aindustriosa/Video-consola-ESP32/hardware/pcb/lista_materiais.csv

Reference | Value | Footprint | QUANTITY
BZ1 | CEM-1203 | Buzzer_Beeper:MagneticBuzzer_ProSignal_ABT-410-RC | 1
C1,C2 | 100nF | PCM_fab:C_1206 | 2
D1 | 1N4148W | PCM_fab:LED_1206 | 1
J2 | TFT ILI9341 | Connector_PinHeader_2.54mm:PinHeader_1x14_P2.54mm_Vertical | 1
J_BAT1 | LiPo_3V7 | Connector_JST:JST_PH_S2B-PH-SM4-TB_1x02-1MP_P2.00mm_Horizontal | 1
M1 | Module_XIAO-ESP32C3 | PCM_fab:SeeedStudio_XIAO_ESP32C3 | 1
Q1 | MMBT3904 | Package_TO_SOT_SMD:SOT-23 | 1
Q2 | Transistor_MOSFET_NCh_SOT23 | PCM_fab:SOT-23-3 | 1
R2,R3 | 4k7 | PCM_fab:R_1206 | 2
R4,R11,R16 | 10K | PCM_fab:R_1206 | 3
R5,R6,R7,R12,R13,R14,R18 | 0 Ohm | PCM_fab:R_1206 | 7
R8,R9 | 100 K | PCM_fab:R_1206 | 2
R10,R17 | 1K | PCM_fab:R_1206 | 2
SW1,SW2,SW3,SW4,SW5,SW6,SW_MENU1 | SW_Push | Button_Switch_THT:SW_PUSH_6mm | 7
U1 | PCF8574A | Package_SO:SOIC-16W_7.5x10.3mm_P1.27mm | 1
