aindustriosa/Video-consola-ESP32/hardware/carcasa/traseira.stl

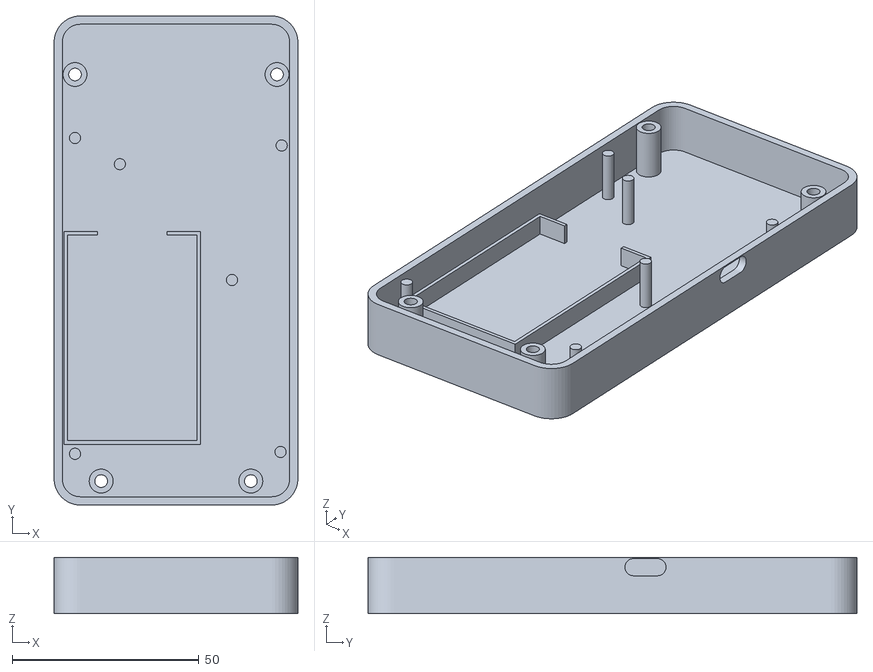
[picture p5: CAD file, 2026-10-26]
hardware/carcasa/traseira.stl
65.2 x 130.8 x 15.0
