aindustriosa/Video-consola-ESP32/hardware/pcb/videoconsola.step

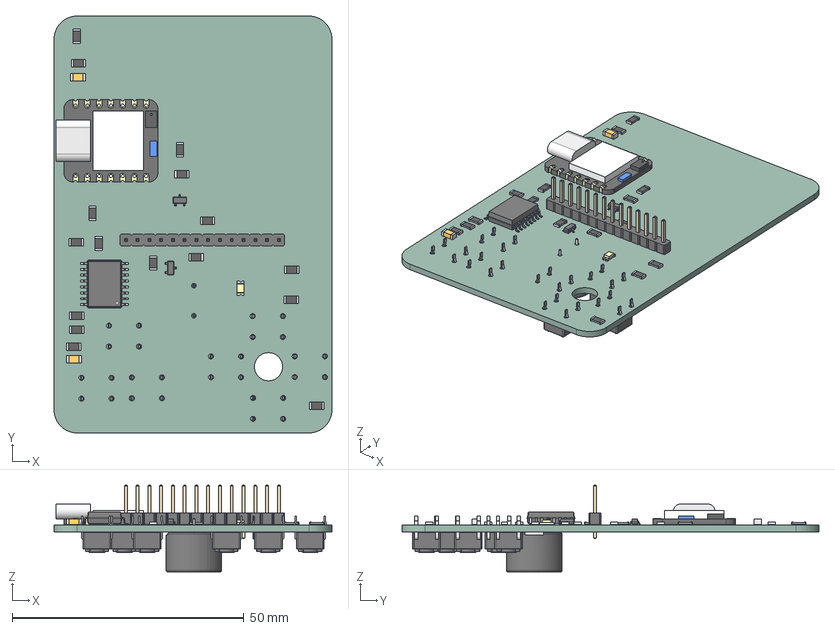
[picture p6: CAD file, 2026-10-26]
hardware/pcb/videoconsola.step
60.0 x 90.0 x 18.8 mm
Ceramic x 16
Contacts x 16
Contacts (Mirror #1) x 16
Overcoat x 16
Contact x 3
ContactClone x 2
Base
Emmiter
Contact_1
Contact_2
SOT-23 x 2
SOIC-16W_7.5x10.3mm_P1.27mm
SoC_nRF_Sense
Mic_nRF_Sense
Antenna_nRF_Sense
Board
USB
PinHeader_1x14_P254mm_Vertical
SW_PUSH_6mm x 7
MagneticBuzzer_ProSignal_ABT_410_RC
videoconsola_PCB
