aindustriosa/Video-consola-ESP32/hardware/carcasa/fronte.stl

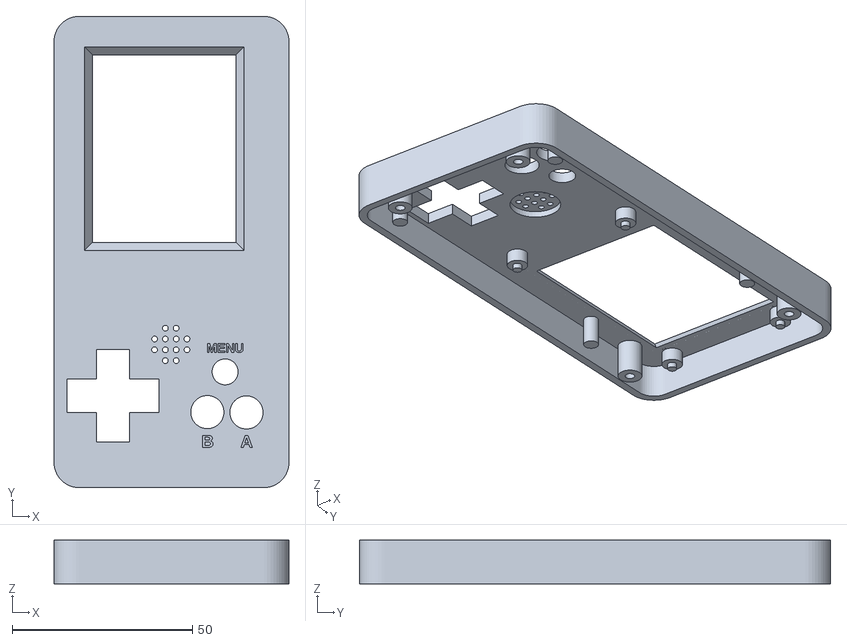
[picture p7: CAD file, 2026-10-26]
hardware/carcasa/fronte.stl
65.2 x 130.8 x 12.2
