aindustriosa/Video-consola-ESP32/hardware/carcasa/botons.stl

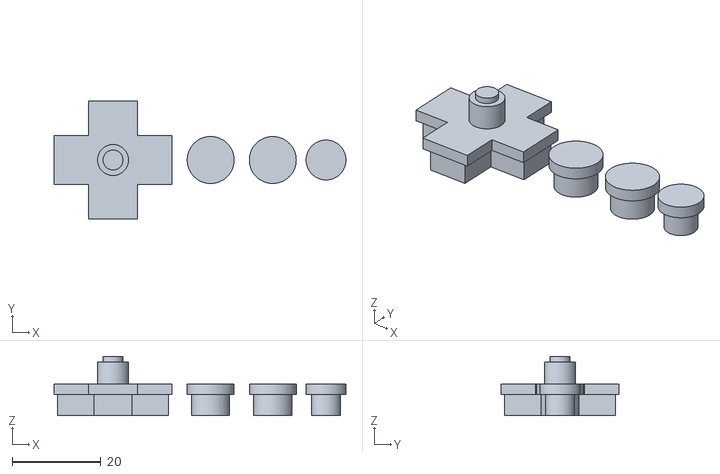
[picture p8: CAD file, 2026-10-26]
hardware/carcasa/botons.stl
65.8 x 26.6 x 13.3
