aindustriosa/Video-consola-ESP32/hardware/pcb/esquema.pdf

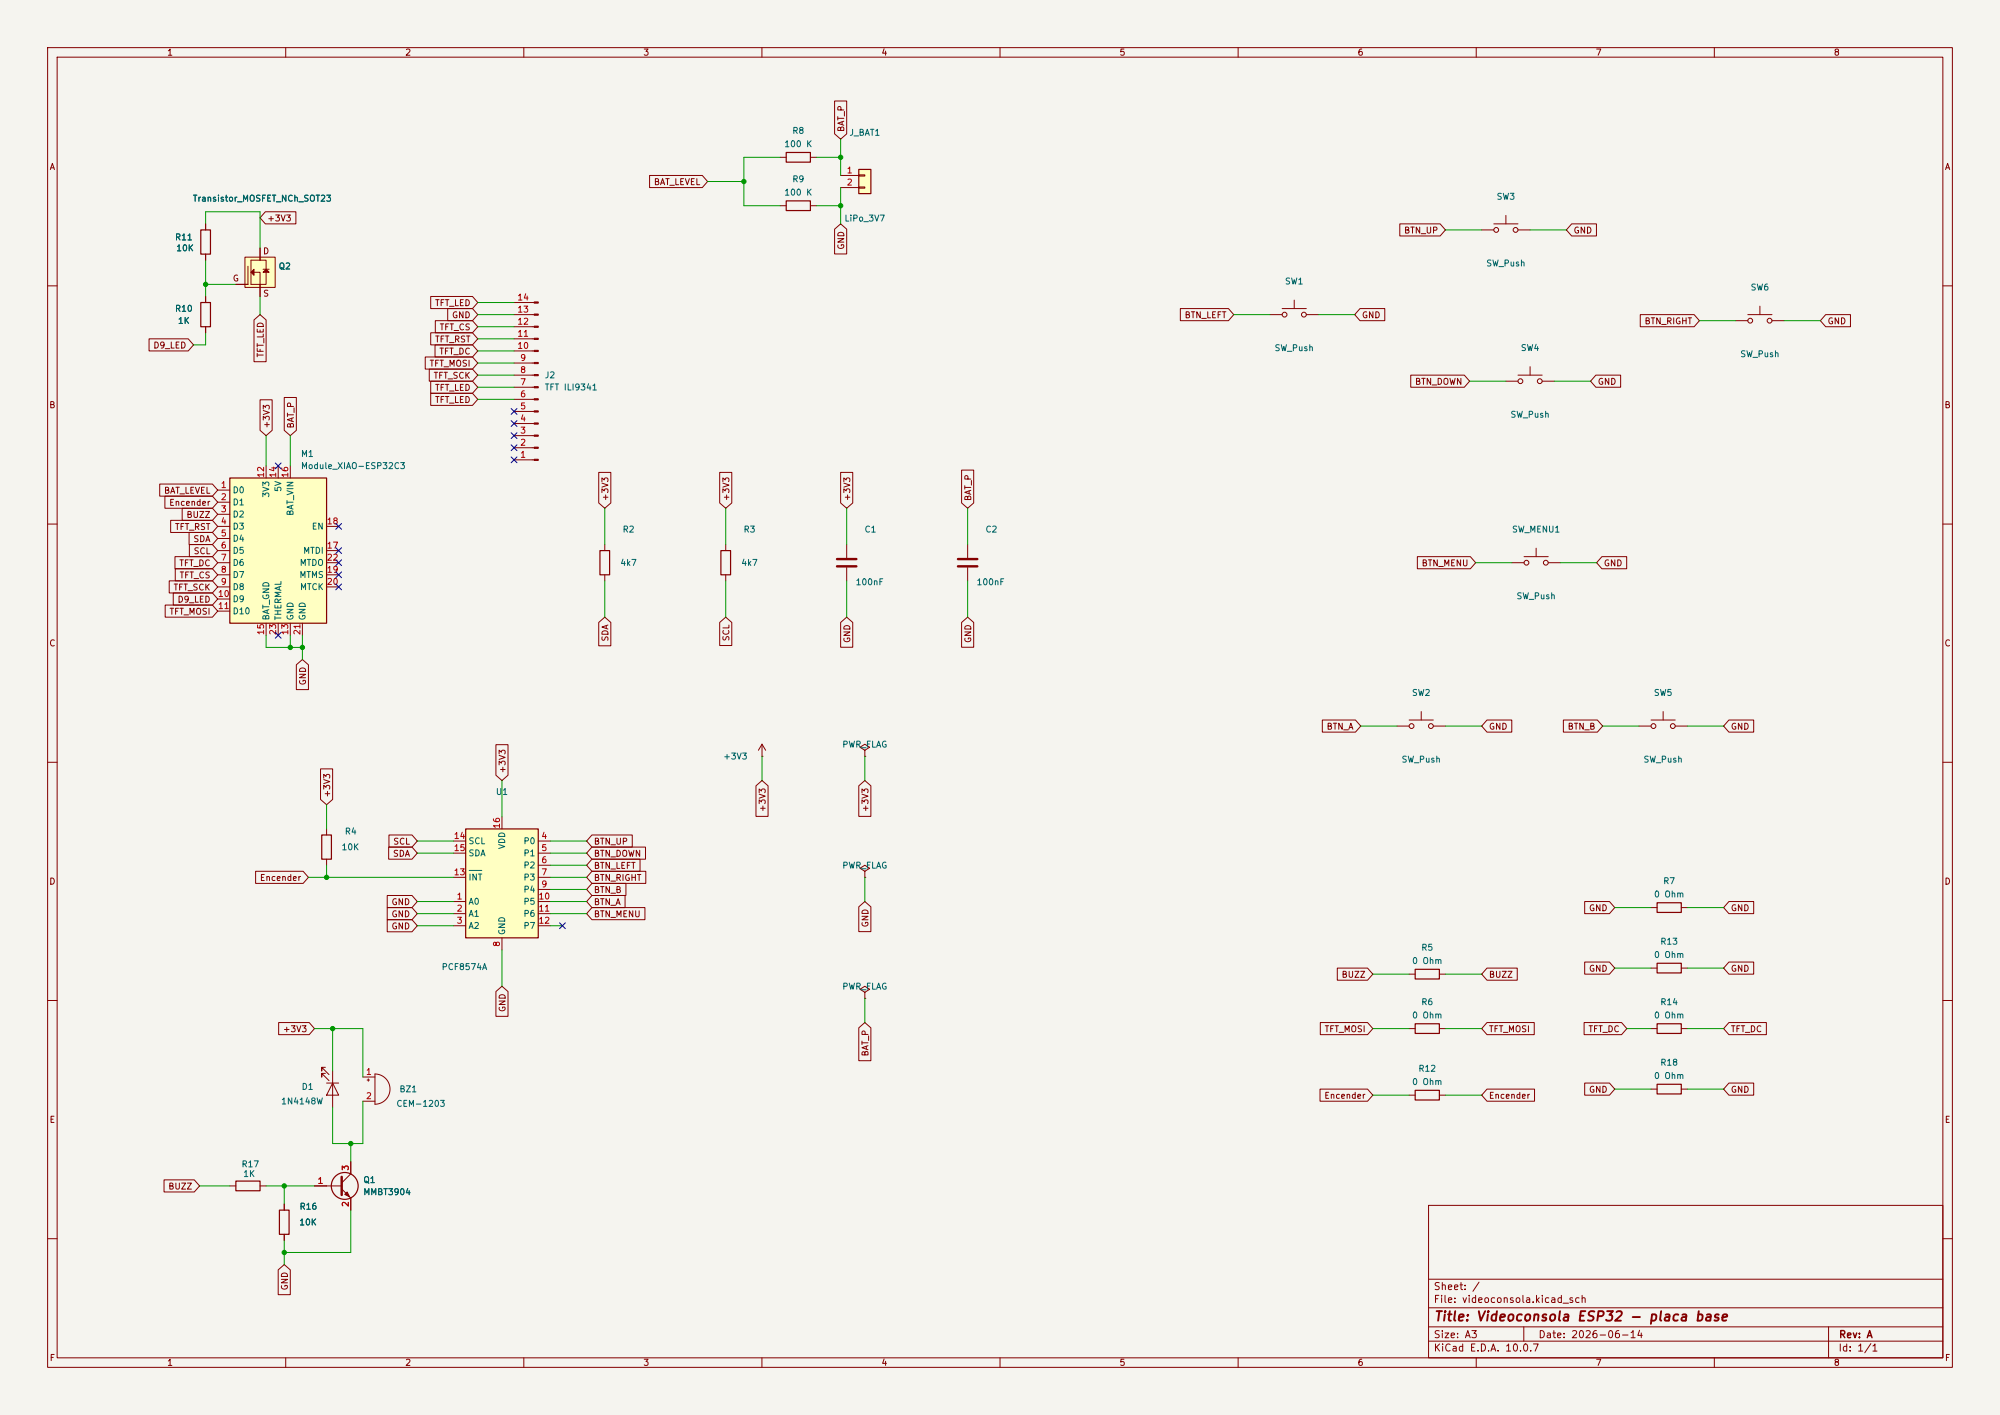
[picture p9: page 1]

Sheet: /
File: videoconsola.kicad_sch
Title: Videoconsola ESP32 - placa base

Size: A3 | Rev: A
KiCad E.D.A. 10.0.7 | Id: 1/1
