aindustriosa/Video-consola-ESP32/hardware/pcb/videoconsola.kicad_pcb

## KiCad design hardware/pcb/videoconsola.kicad_pcb (2026-10-26)

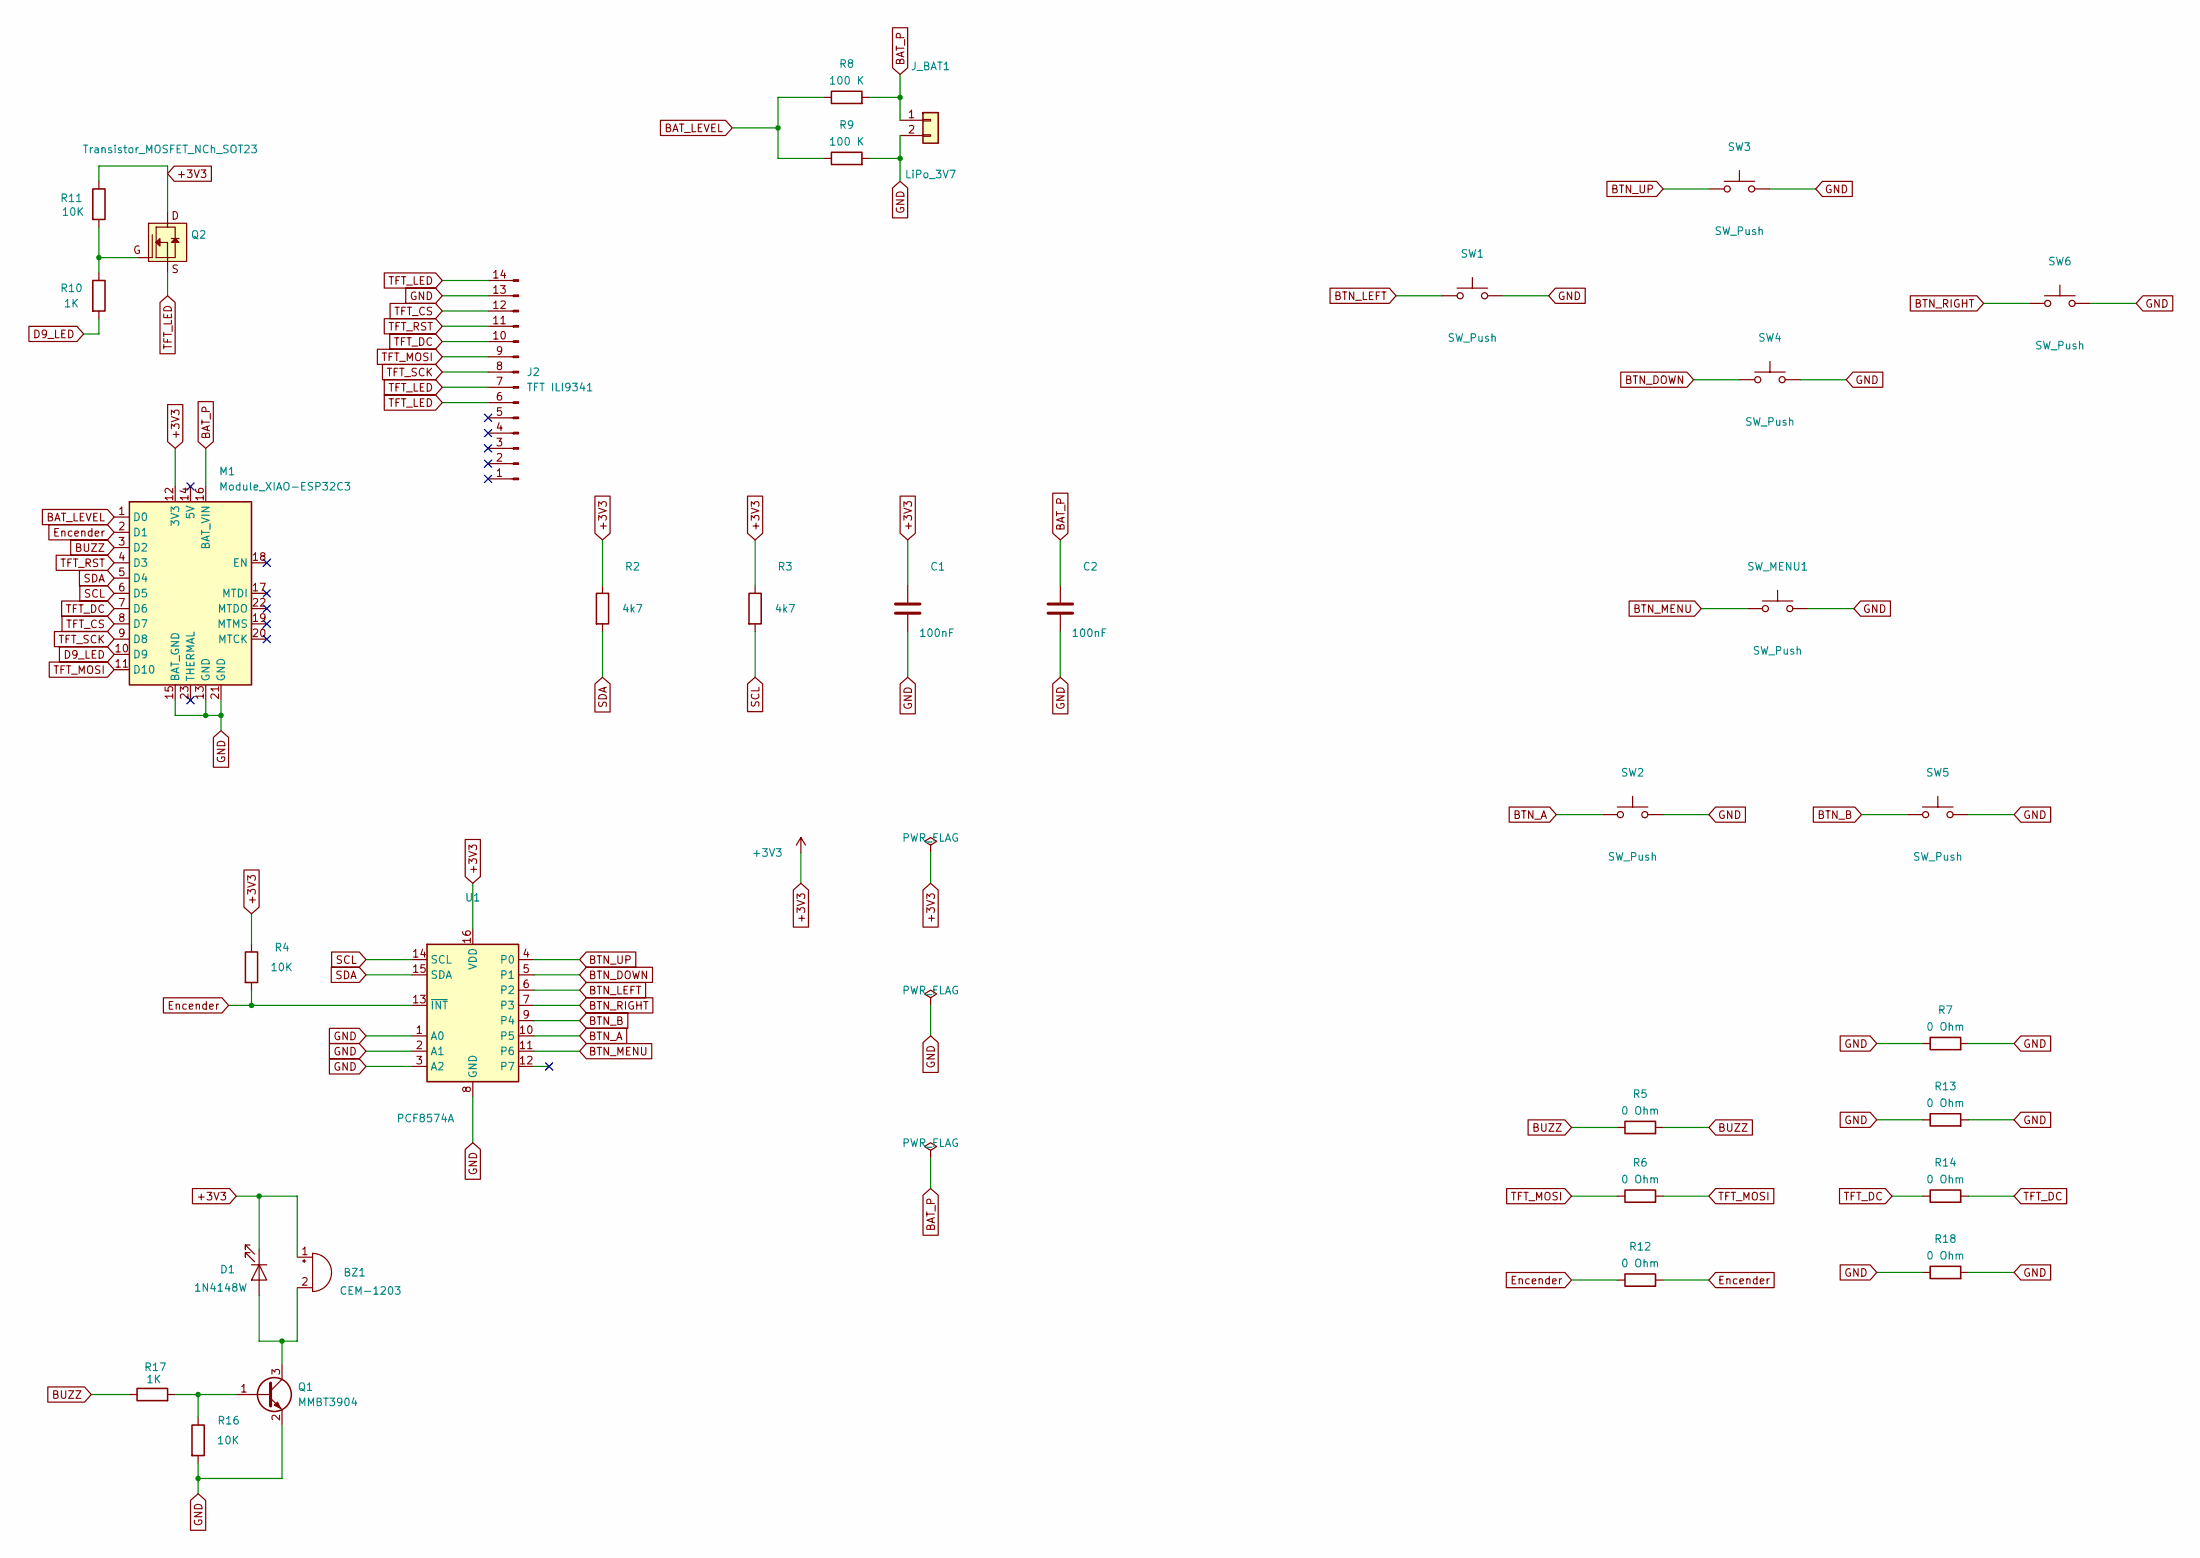
[picture p10: schematic videoconsola.kicad_sch, Videoconsola ESP32 - placa base]

Parts:
BZ1: CEM-1203; MagneticBuzzer_ProSignal_ABT-410-RC
C1, C2: 100nF; C_1206
D1: 1N4148W; LED_1206
J2: TFT ILI9341; PinHeader_1x14_P2.54mm_Vertical
J_BAT1: LiPo_3V7; JST_PH_S2B-PH-SM4-TB_1x02-1MP_P2.00mm_Horizontal
M1: Module_XIAO-ESP32C3; SeeedStudio_XIAO_ESP32C3
Q1: MMBT3904; SOT-23
Q2: Transistor_MOSFET_NCh_SOT23; SOT-23-3
R2, R3: 4k7; R_1206
R4, R11, R16: 10K; R_1206
R5, R6, R7, R12, R13, R14, R18: 0 Ohm; R_1206
R8, R9: 100 K; R_1206
R10, R17: 1K; R_1206
SW1, SW2, SW3, SW4, SW5, SW6: SW_Push; SW_PUSH_6mm
SW_MENU1: SW_Push; SW_PUSH_6mm
U1: PCF8574A; SOIC-16W_7.5x10.3mm_P1.27mm

Connections:
+3V3: BZ1.1 (+), C1.1, D1.1 (K), M1.12 (3V3), Q2.3 (D), R2.1, R3.1, R4.1, R11.1, U1.16 (VDD)
BAT_LEVEL: M1.1 (D0), R8.1, R9.1
BAT_P: C2.1, J_BAT1.1, M1.16 (BAT_VIN), R8.2
BTN_A: SW2.1, U1.10 (P5)
BTN_B: SW5.1, U1.9 (P4)
BTN_DOWN: SW4.1, U1.5 (P1)
BTN_LEFT: SW1.1, U1.6 (P2)
BTN_MENU: SW_MENU1.1, U1.11 (P6)
BTN_RIGHT: SW6.1, U1.7 (P3)
BTN_UP: SW3.1, U1.4 (P0)
BUZZ: M1.3 (D2), R5.1, R5.2, R17.1
D9_LED: M1.10 (D9), R10.2
Encender: M1.2 (D1), R4.2, R12.1, R12.2, U1.13 (~INT)
GND: C1.2, C2.2, J2.13, J_BAT1.2, M1.13 (GND), M1.15 (BAT_GND), M1.21 (GND), Q1.2 (E), R7.1, R7.2, R9.2, R13.1, R13.2, R16.2, R18.1, R18.2, SW1.2, SW2.2, SW3.2, SW4.2, SW5.2, SW6.2, SW_MENU1.2, U1.1 (A0), U1.2 (A1), U1.3 (A2), U1.8 (GND)
unnamed: BZ1.2 (-), D1.2 (A), Q1.3 (C)
unnamed: Q1.1 (B), R16.1, R17.2
unnamed: Q2.1 (G), R10.1, R11.2
SCL: M1.6 (D5), R3.2, U1.14 (SCL)
SDA: M1.5 (D4), R2.2, U1.15 (SDA)
TFT_CS: J2.12, M1.8 (D7)
TFT_DC: J2.10, M1.7 (D6), R14.1, R14.2
TFT_LED: J2.6, J2.7, J2.14, Q2.2 (S)
TFT_MOSI: J2.9, M1.11 (D10), R6.1, R6.2
TFT_RST: J2.11, M1.4 (D3)
TFT_SCK: J2.8, M1.9 (D8)

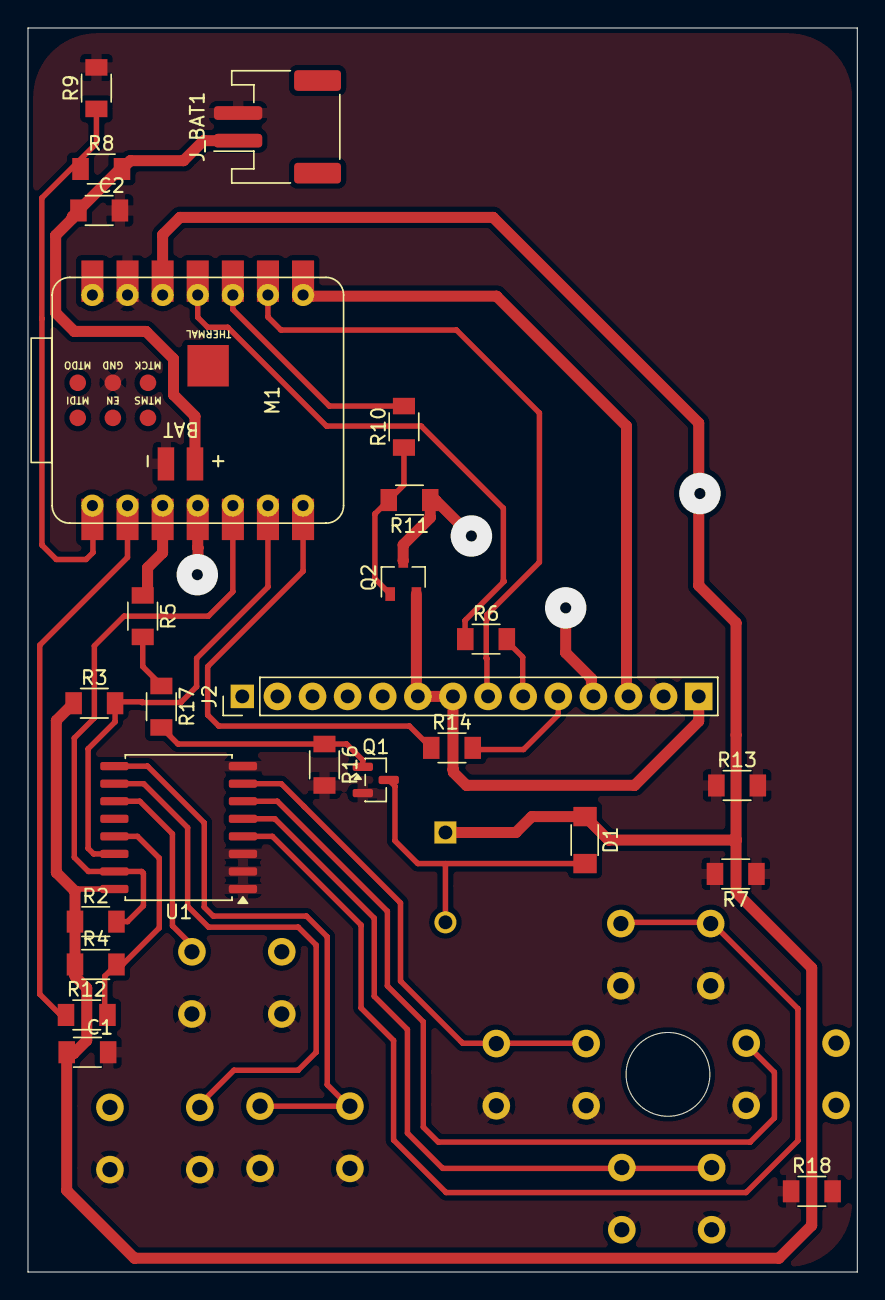
[picture p11: board videoconsola.kicad_pcb from above]

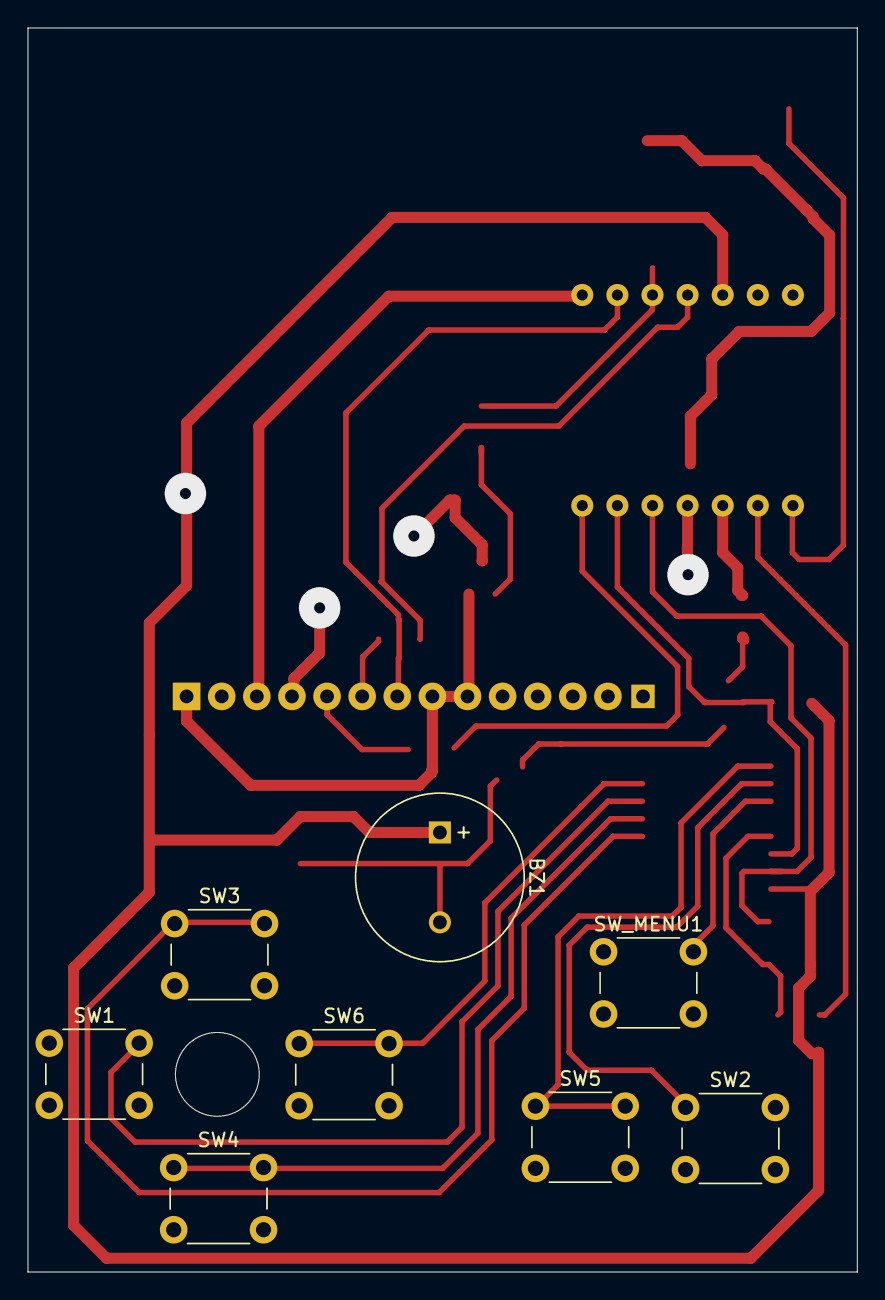
[picture p12: board videoconsola.kicad_pcb from below]

Board: 2 copper layers, 60.0 x 90.0 mm, 33 parts (8 on the bottom side), 25 nets.
